DocTu06/CanSat_NEXUS/readme.txt

This repository contains the final files for the NEXUS team's CanSat project for backup purposes. 
These files include the main programs for the microcontrollers on the transmitter and receiver, as well as the team logo, 3d models, schematics and drawings
