DocTu06/CanSat_NEXUS/3d models/CanSat NEXUS.step

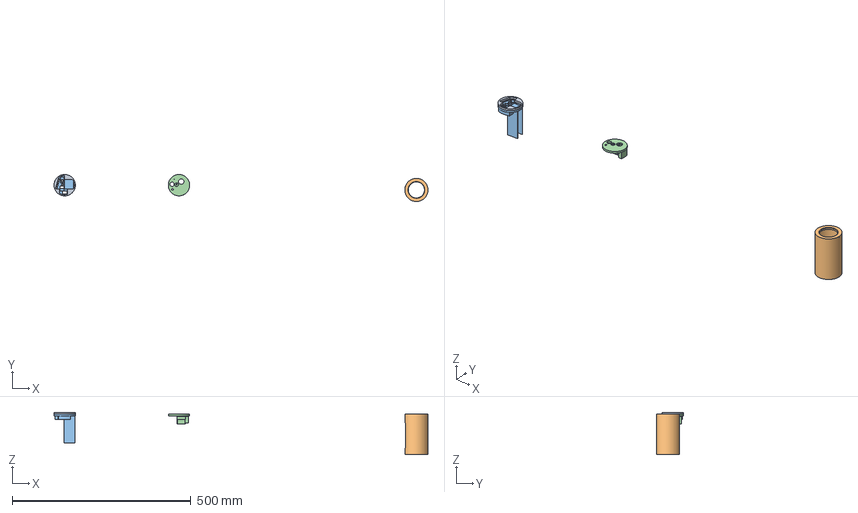
[picture p1: CAD file, 2022-06-18]
3d models/CanSat NEXUS.step
1047.4 x 75.8 x 118.0 mm
bottom plate
bottom structure
top structure
