DocTu06/CanSat_NEXUS/(list of files, cad)

Other CAD files:
3d models/CanSat NEXUS.f3d
3d models/NEXUS receiver box.f3d
