DocTu06/CanSat_NEXUS/drawings/NEXUS CanSat exploded drawing.pdf

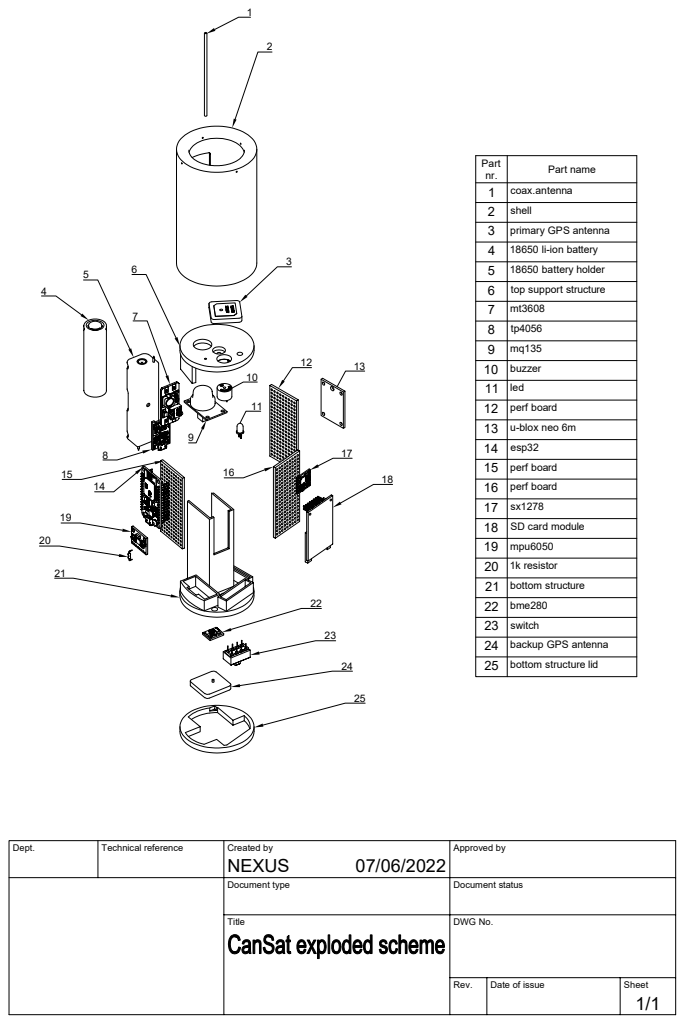
[picture p2: page 1]
Dept.; Technical reference; Created by; Approved by; Document type; Document status; Title; DWG No.; Rev.; Date of issue; Sheet; NEXUS; Part nr.; Part name; 1 coax.antenna; 2 shell; 3 primary GPS antenna; 4 18650 li-ion battery; 5 18650 battery holder; 6 top support structure; 10 buzzer; 11 led; 12 perf board; 13 u-blox neo 6m; 14 esp32; 15 perf board; 16 perf board; 18 SD card module; 19 mpu6050; 20 1k resistor; 21 bottom structure; 22 bme280; 23 switch; 24 backup GPS antenna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
