DocTu06/CanSat_NEXUS/schematics/NEXUS CanSat schematic.pdf

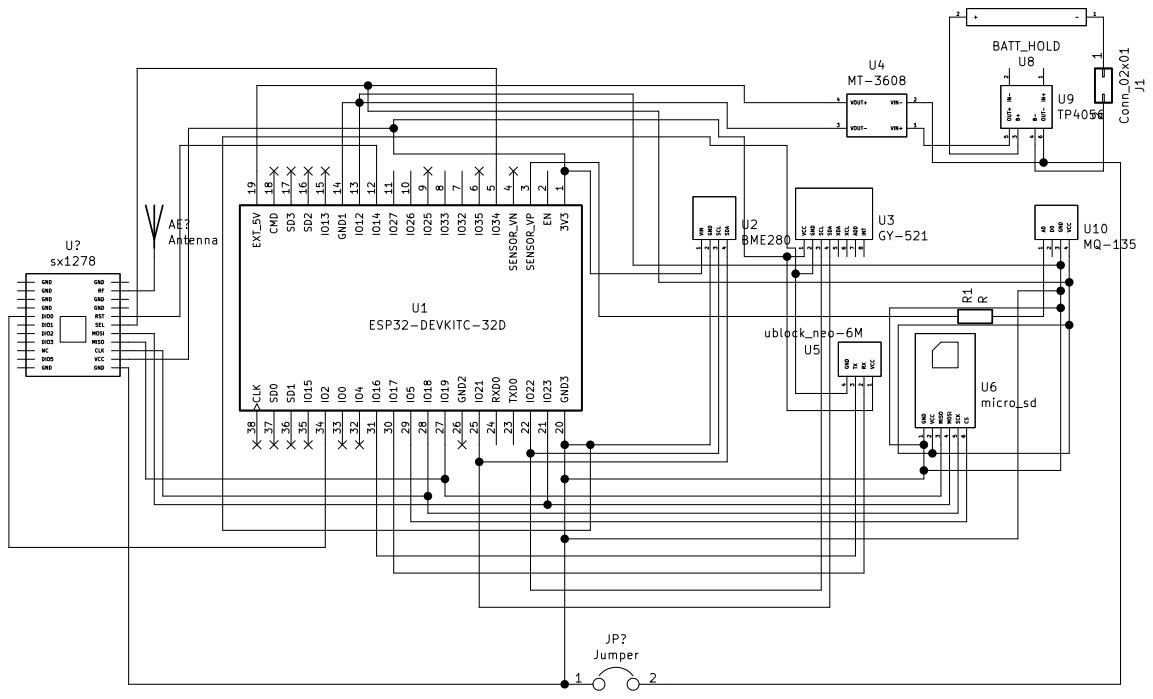
[picture p3: page 1]

RF RST SEL VCC U?

File: cansat.sch Sheet: / NEXUS

Id: 1/1 Title: CANSAT NEXUS
