DocTu06/CanSat_NEXUS/schematics/eschema/NEXUS CanSat schematic.sch

## KiCad design schematics/eschema/NEXUS CanSat schematic.sch (2022-06-18)

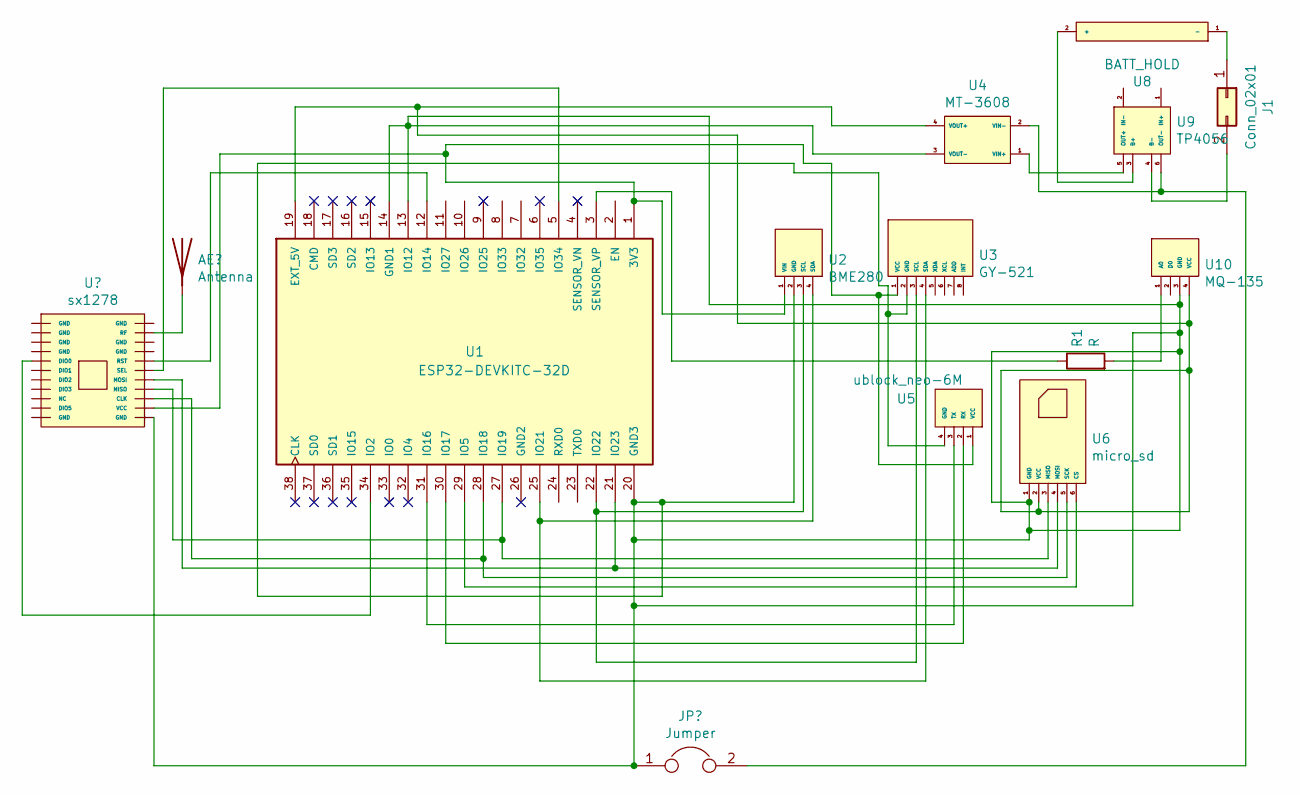
[picture p4: schematic NEXUS CanSat schematic.sch]

Parts:
J1: Conn_02x01; PinSocket_2x01_P2.54mm_Horizontal
R1: R; R_Axial_DIN0207_L6.3mm_D2.5mm_P7.62mm_Horizontal
U1: ESP32-DEVKITC-32D; MODULE_ESP32-DEVKITC-32D; PARTREV 4
U2: BME280; PinHeader_1x04_P2.54mm_Horizontal
U3: GY-521; PinHeader_1x08_P2.54mm_Horizontal
U4: MT-3608; MT3608_module
U5: ublock_neo-6M; PinHeader_1x04_P2.54mm_Horizontal
U6: micro_sd; PinHeader_1x06_P2.54mm_Horizontal
U8: BATT_HOLD; PinHeader_1x02_P2.54mm_Horizontal
U9: TP4056; 4056E_LiIon_loader
U10: MQ-135; PinHeader_1x04_P2.54mm_Horizontal

Connections:
unnamed: J1.1, U8.1 (-)
unnamed: J1.2, U9.4 (B-)
unnamed: R1.1, U1.3 (SENSOR_VP)
unnamed: R1.2, U10.1 (A0)
unnamed: U1.1 (3V3), U2.1 (VIN), U3.1 (VCC), U5.1 (VCC)
unnamed: U1.13 (IO12), U1.14 (GND1), U1.20 (GND3), U2.2 (GND), U3.2 (GND), U4.3 (VOUT-), U5.4 (GND), U6.1 (GND), U10.3 (GND)
unnamed: U1.19 (EXT_5V), U4.4 (VOUT+), U6.2 (VCC), U10.4 (VCC)
unnamed: U1.21 (IO23), U6.4 (MOSI)
unnamed: U1.22 (IO22), U2.3 (SCL), U3.3 (SCL)
unnamed: U1.25 (IO21), U2.4 (SDA), U3.4 (SDA)
unnamed: U1.27 (IO19), U6.3 (MISO)
unnamed: U1.28 (IO18), U6.5 (SCK)
unnamed: U1.29 (IO5), U6.6 (CS)
unnamed: U1.30 (IO17), U5.2 (RX)
unnamed: U1.31 (IO16), U5.3 (TX)
unnamed: U4.1 (VIN+), U9.5 (OUT+)
unnamed: U4.2 (VIN-), U9.6 (OUT-)
unnamed: U8.2 (+), U9.3 (B+)
